Gadgetoid/brainwave/(commit log)

2026-10-28 Add Brainwave: a Pico LiPo 2 XL W USB WiFi module for the SHARP Brain
    RP2350 firmware: RNDIS host, DHCP, DNS relay and address translation
    to WiFi, a control service, A/B OTA updates with rollback, and crash
    capture. Brainwave WiFi, the CE app: network picker, details, tray
    icon, firmware updates and a card-loaded power driver that runs the
    Brain from its own battery while attached.
    [app.cpp, app.h, battery.cpp, brain_link.cpp, brain_link.h]
2026-10-28 Leave Debug Agent running when switching USB to networking
    Debug Agent now follows the switch to RNDIS itself, so there is no
    need to stop and restart it.
2026-10-28 Tighten the docs and fix the Start menu path in the user guide
2026-10-28 Add WEP joins and stop TinyUSB host errors panicking
    Patch cyw43-driver with open and shared key WEP and TinyUSB's RP2040
    host port to fail a transfer on a data sequence error and clear a
    stale buffer after a detach instead of panicking. CMake applies both
    patches to copies in the build directory. The app accepts WEP keys
    of 5 or 13 characters or 10 or 26 hex digits.
    [control.cpp, ui_networks.cpp, ui_password.cpp, wifi.cpp]
2026-10-28 Clear the station address when leaving a network
    lwIP kept the previous network's lease across a switch, so the next
    join looked connected at once with a stale address, then dropped and
    fell back to the old network. Reset the link, address and DHCP on
    every leave.
    [wifi.cpp]
